antonysigma/peltier-cooler-4ch/README.md

# 4-channel Peltier cooler, 30W per channel

The custom PCB to control up to 4 individual Peliter coolers
interfacing the high power laser modules.

Technical specifications:

* Input: 24VDC, max 20A.

* Output per channel: up to 10A, PWM at 5% to 100% duty cycle.
  [30N06L](https://cdn.sparkfun.com/datasheets/Components/General/FQP30N06L.pdf)

* Recommended Peltier module: [series-parallel
  modules](https://tetech.com/wp-content/uploads/2013/11/SP-254-1.0-1.5.pdf)
  supporting up to 24VDC input, with up to 50W heat transfer on the cold side.

* Temperature sensor: Dallas digital temperature sensor with Onewire interface.
  [DS18B20](https://www.analog.com/media/en/technical-documentation/data-sheets/ds18b20.pdf)

* Microcontroller (MCU) power supply: 5VDC, max 200mA. Completely separated from
  the 12DVC supply.

* MCU programming interface: UART over TTL, via a 6-pin connecter with the [FTDI
  friend USB adapter](https://www.adafruit.com/product/284).

* External set point control: I2C bus to reduce the cabling effort.

## Why I made my own board

The board is primarily used to dissipate the waste heat from the
[3,000mW laser modules](https://www.ushio.com/product/necsel-green-laser-53x/). A high laser
power is required to compensate the coupling loss of the homogenizing liquid
light-guide and the TV lens, so that I can excite the fluorescence-stained
mammalian cells on all 96 wells of the multi-well plate (area: 180mm x 90mm).

At the time, there was an urgent need to create an evaluation board at less than
10% of the cost of the OEM laser parts. So, the OEM provided temperature
controller evaluation kits were a no go.

## Preview

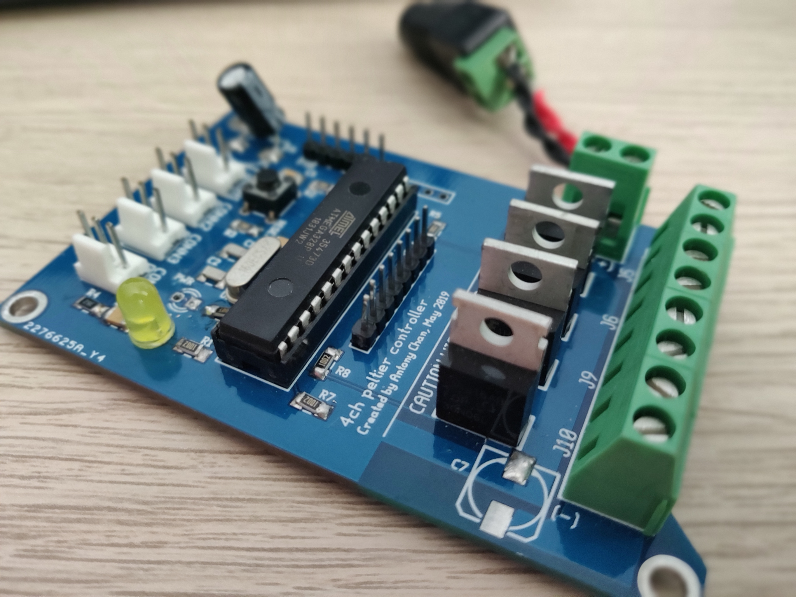
[picture p1: preview.jpg]


## Schematics

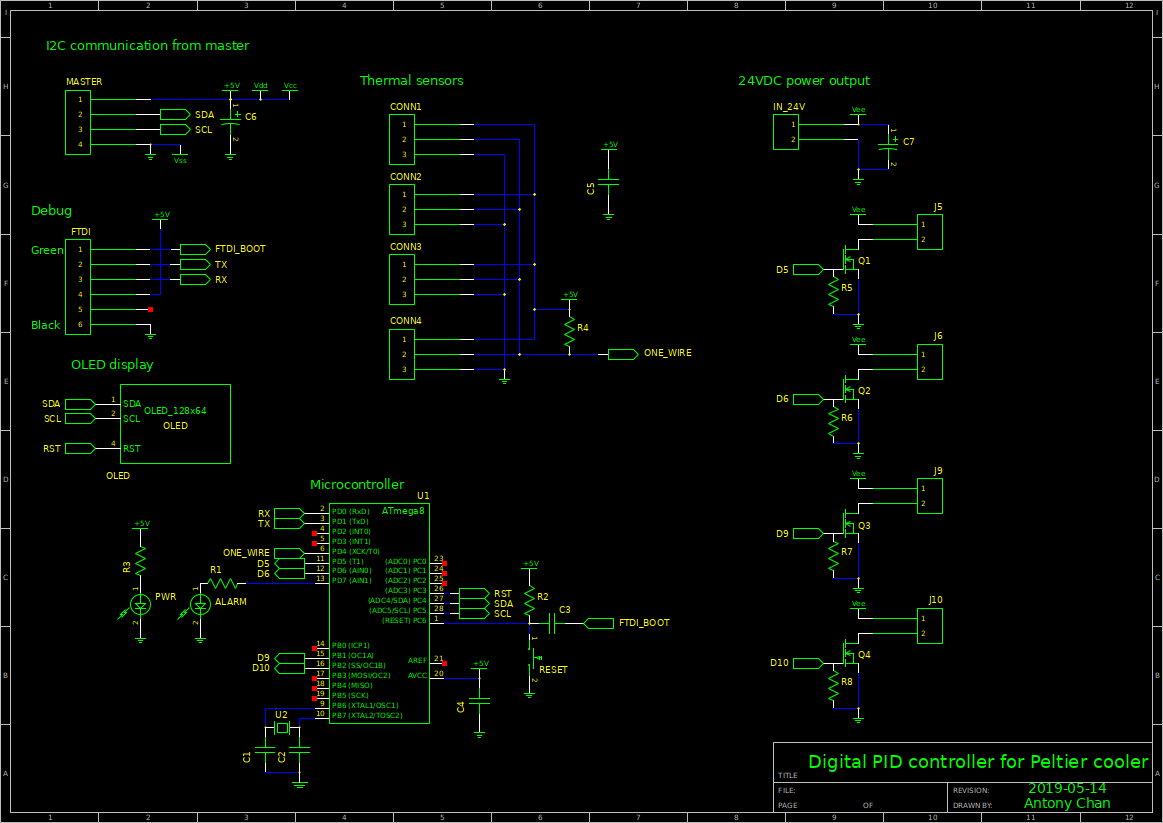
[picture p2: schematic.png]


## PCB routing

If I were to route the PCB again, I would have increased the pin-to-pin
separation of the TO-220 package to avoid short circuit. One way to solve this
is to draw a "tripod" footprint.

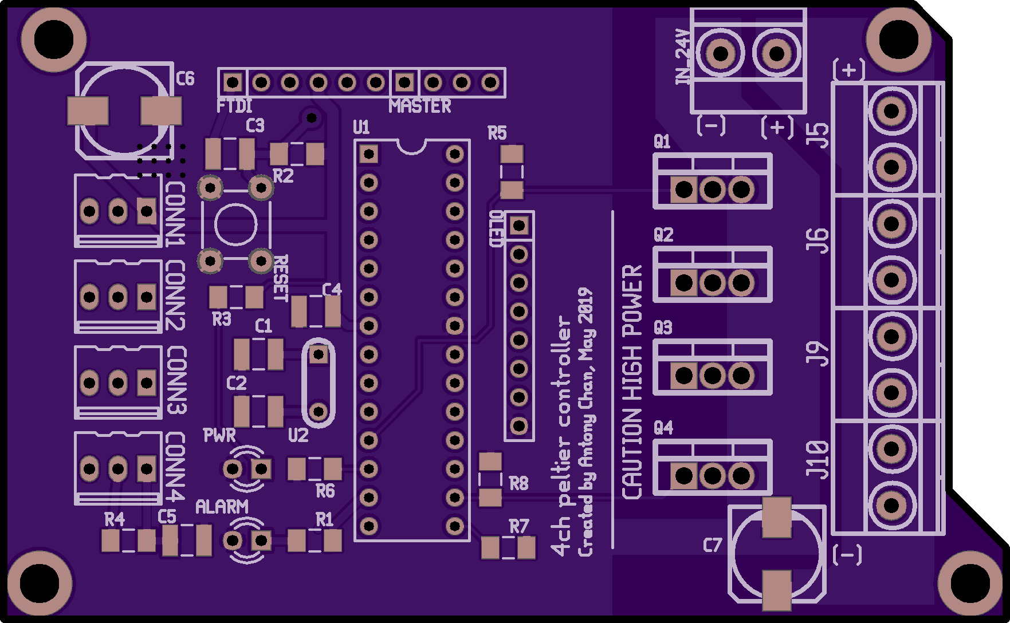
[picture p3: pcb-top.png]


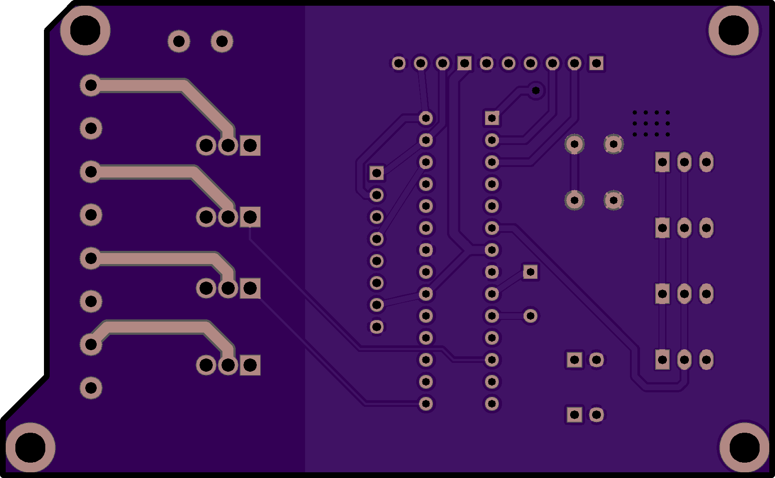
[picture p4: pcb-bottom.png]


## Literatures

* The effect of pulse width modulation (PWM) frequency on the realiability of thermoelectric modules.
  https://tetech.com/wp-content/uploads/2013/10/ICT99MJN.pdf

<br />This work
is licensed under a <a rel="license"
href="http://creativecommons.org/licenses/by-sa/4.0/">Creative Commons
Attribution-ShareAlike 4.0 International License</a>.
