antonysigma/peltier-cooler-4ch/(list of files, drawings)

Other design files:
schematic/peltier_cooler.pcb
