antonysigma/peltier-cooler-4ch/(commit log)

2019-05-14 Initial files
    [galvo-arduino.pcb, galvo-arduino.sch]
2019-05-14 Rename files
    [peltier_cooler.pcb, peltier_cooler.sch]
2019-05-14 New footprints
2019-05-14 connector for OLED
2019-05-14 Edit pinout of the mosfet
    [peltier_cooler.sch]
2019-05-14 Placed elements onto the PCB board
    [peltier_cooler.pcb, peltier_cooler.sch]
2019-05-14 Complete routing
    [peltier_cooler.pcb, peltier_cooler.sch]
2019-05-14 Expose trace copper
    [peltier_cooler.pcb]
2019-05-14 A few more thermal connections
    [peltier_cooler.pcb]
2019-05-14 Increase 24VDC surface area
    [peltier_cooler.pcb]
2019-05-14 Add labels and signatures
    [peltier_cooler.pcb, peltier_cooler.sch]
2019-05-14 Uniform drill diameter
    [peltier_cooler.pcb]
2019-05-14 Equal spacing of MOSFET
    [peltier_cooler.pcb]
2019-05-16 Change to SMT for electrolytic capacitor
    [peltier_cooler.pcb, peltier_cooler.sch]
2019-05-16 Update Mouser part list; align screw terminals
    [peltier_cooler.pcb, peltier_cooler.sch]
2019-05-16 Add mounting holes; separate analog ground from digital
    [peltier_cooler.pcb]
2019-05-17 Should be n-channel mosfet
    [peltier_cooler.pcb, peltier_cooler.sch]
2019-05-30 More spacing between the pins of the mosfets
    [peltier_cooler.pcb, peltier_cooler.sch]
2023-05-01 Move schematic design files to sub-folder
    [peltier_cooler.pcb, peltier_cooler.sch]
2023-05-02 Attach full license legal terms
2023-05-02 Eliminate floating handling logic in Arduino GFX
